araobp/can-bus/doc/requirements.pptx

Sensor/actuator CAN node

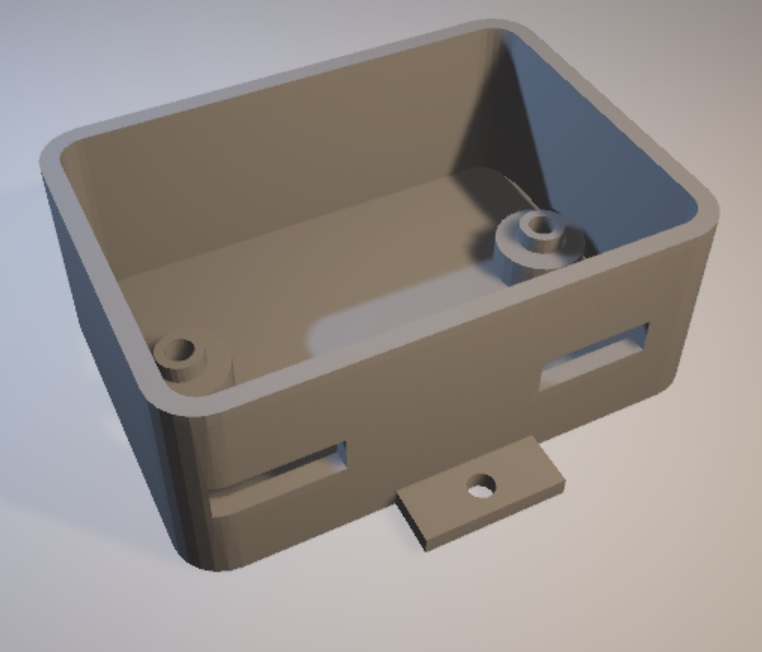
[picture p14: figure]
壁, 容器, 室内 が含まれている画像 非常に高い精度で生成された説明

Requirements for sensor/actuator node
- MCP2515 and MCP2561 on base board
- 5V three-terminal regulator (Max. 500mA)
- Polyswitch (100mA) and diode for circuit protection
- PIC16F1829 MCU on sensor/actuator board (daughter board)

CAN1

CANL

CANH

CANL

CANH

CAN0

RX

TX

GND

6V~9V

UART
