araobp/can-bus/doc/concept.pptx

Low-Power LAN

LAN and the Internet

Home controller on AWS

MQTT
client

Wireless
Sensor
(BLE etc)

Gateway
supporting CAN

Application on
RasPi or Android

CAN-MQTT Gateway
“gateway.js” on RasPi

Home controller on
RasPi or Android

Sensor
supporting CAN

Actuator
supporting CAN

CAN adapter
to UART

CAN adapter
to UART

MQTT
client

MQTT
client

MQTT-bus

- Low power consumption (a few ten mA @ 5V)
- Long range (> 50m)
- Realtime control support
- Peer-to-peer, not master-slave

CAN-bus

- Message bus over IP
- Optimized for IoT

Note: RasPi has four USB ports: can support four CAN-buses in parallel.
