araobp/can-bus/doc/universal_board.pptx

PIC16F1825 CAN node

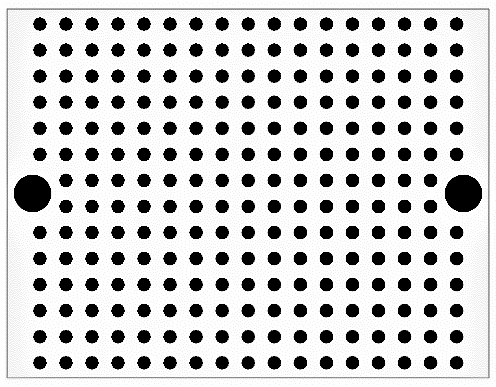
[picture p15: figure]

Murata CERALOCK 8MHz

(2)

(3)

(1)

MCP2515

VSS

OSC1

OSC2

0.1μF

RXCAN

TXCAN

SCK

SI

SO

CS

RESET

VDD

10kΩ

RA2

0.1μF

MCP2561

PIC16F1825

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
CANH

VSS

TXD

120Ω

0.1μF

51kΩ

SPLIT

CANL

STBY

JP1

VDD

Short JP1 for
120Ω termination.

UART

RX

TX

VSS

VDD

CANH

CANL

CAN

CANL

CANH

CAN
