araobp/can-bus/doc/pic16f1825-mcp2515.pptx

Tx

UART/USB(FTDI)

Rx

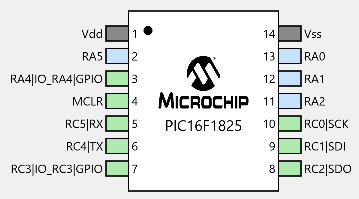
[picture p16: figure]

INT

SCK

SI

J1

CANH

SO

CANL

CS

GND

VCC

120Ω
