araobp/can-bus/doc/logic_16micro.jpg

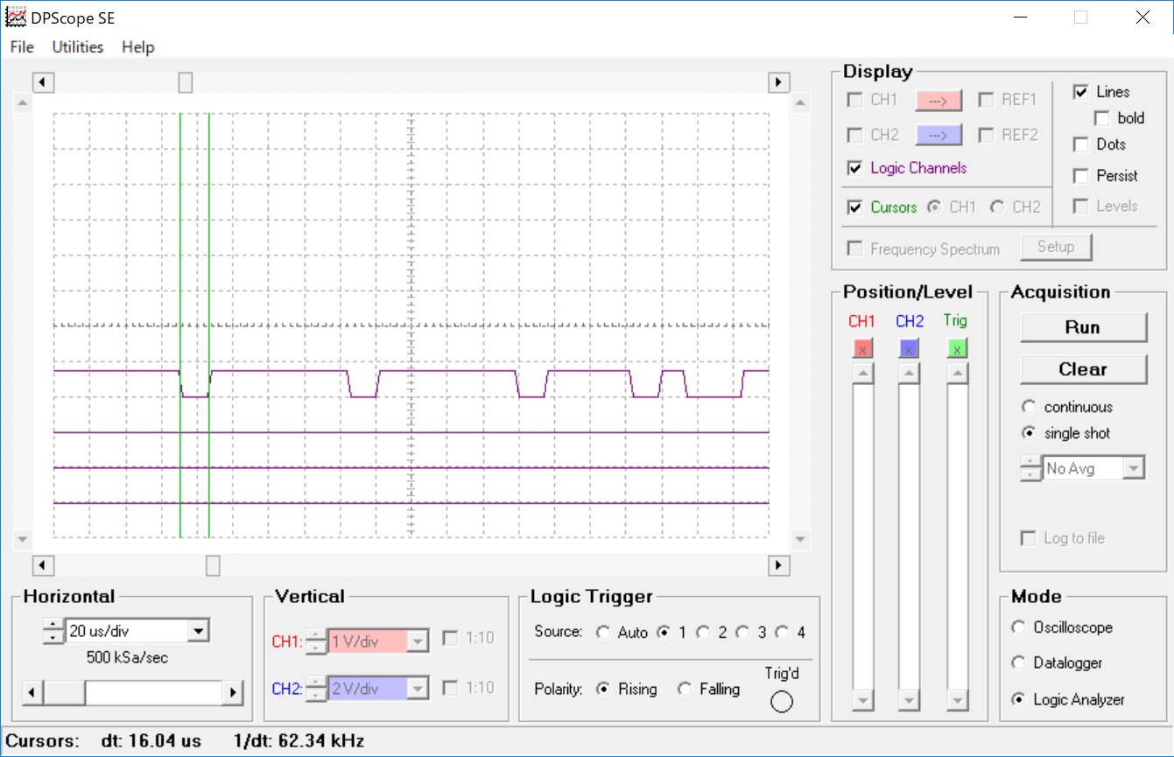
doc/logic_16micro.jpg
