araobp/can-bus/FreeCAD/adapter_to_uart_spacer.FCStd

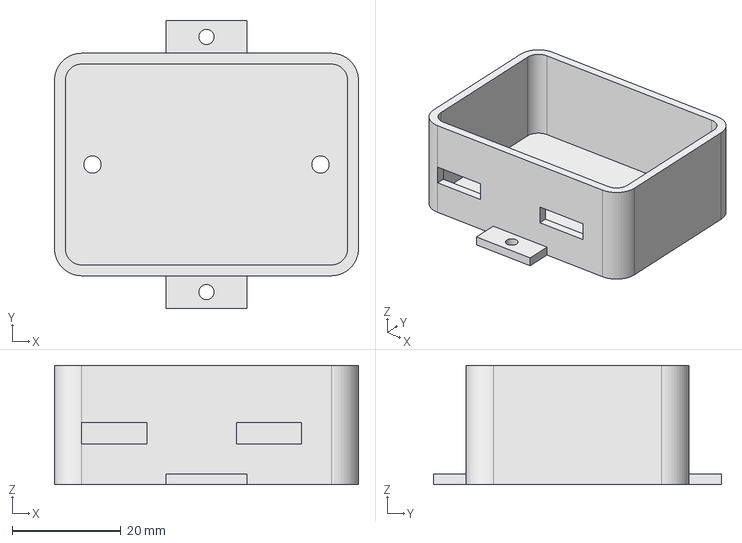
[picture p18: CAD file, 2018-04-01]
FreeCAD/adapter_to_uart_spacer.FCStd
56.0 x 53.0 x 22.0 mm
