araobp/can-bus/FreeCAD/adapter_to_uart.FCStd

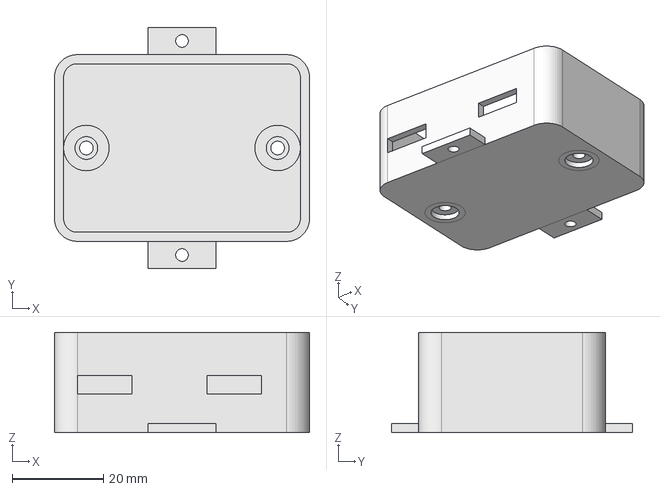
[picture p19: CAD file, 2018-04-01]
FreeCAD/adapter_to_uart.FCStd
56.0 x 53.0 x 22.0 mm
