araobp/can-bus/(list of files, cad)

Other CAD files:
pic16f1825/uart2can.X/dist/default/production/uart2can.X.production.obj
FreeCAD/adapter_to_uart_serial.stl
FreeCAD/adapter_to_uart.stl
