araobp/can-bus/doc/soldering.jpg

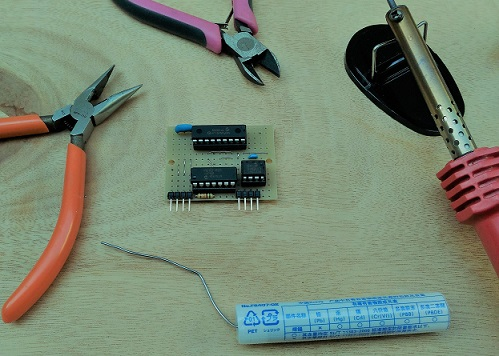
doc/soldering.jpg
