araobp/can-bus/doc/EVALUATION.md

# CAN evaluation

## Research

### Arm mbed

I evaluated ARM mbed with CAN (LPC1768/MCP2561), but ARM Cortex-M is not suitable for the goal: expensive and over spec.

The following is the waveform of CAN over the network between two LPC1768:

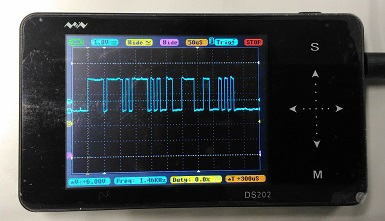
[picture p21: doc/waveform.jpg]
waveform


And the physical network:

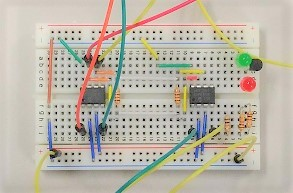
[picture p22: doc/breadboard.jpg]
breadboard


### SocketCAN and SLCAN

SocketCAN and SLCAN are interesting, so I evaluated them by re-building Raspbian to add SLCAN kernel module. But I noticed that SLCAN does not support mask/filtering on CAN controller, so I do not adopt them in this project.

## CANopen

CANopen is over-spec for this project. I will add a thin layer on top of CAN-bus instead of CANopen, because I want to use cheap and low-power 8bit MCUs such as PIC16F1 for CAN nodes.

## My original PIC16F1825 evaluation board

I use this PIC board to evaluate CAN:

pico

## Wiring with jumper cables

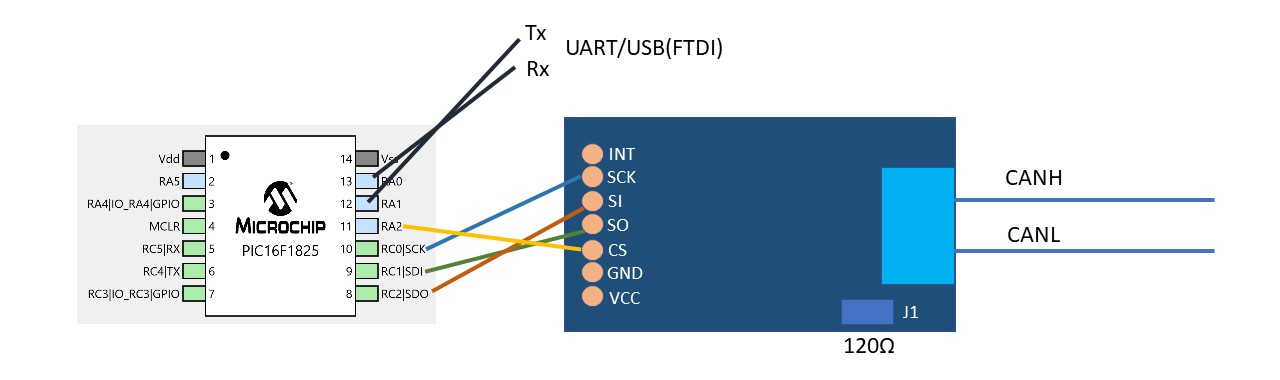
[picture p23: doc/pic16f1825-mcp2515.jpg]
connection


## 1st test on March 14th, 2018

(The problem below has already been fixed in ver 0.1 release)

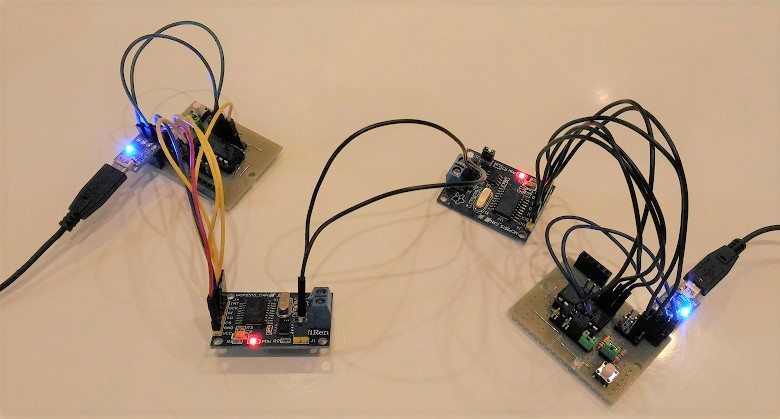
[picture p24: doc/test.jpg]
test


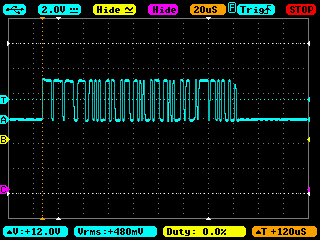
[picture p25: doc/waveform2.BMP]
waveform2


It seemed like I forgot to set CNF1, CNF2 and CNF3 to appropriate values to generate 125kbps baudrate.

Assuming that the oscillator runs at 8MHz and BRP(Buad Rate Prescaller) = 2,

```
TQ = 2*2/8MHz = 500ns  ... Equation 5-2 in P38
16TQ corresponds to 125kHz

According to 5.3 in P 41,
SyncSeg = 1 TQ,
PropSeg = 2 TQ,
PS1 = 7TQ,
PS2 = 6TQ.

Total 16TQ.

CNF1 in P42
SJW: 01
BRP: 000001

CNF2
BTLMODE: 1
SAM: 1
PHSEG1: 110
PRSEG: 001

CNF3
SOF: 0
WAKFIL: 0
PHSEG2: 101
```

So the values of CNF1, CNF2 and CNF3 would be like this:

|Register | Value  |
|---|---|
|CNF1(2Ah)|01000001|
|CNF2(29h)|11110001|
|CNF3(28h)|00000101|

## Baud rate test on March 17th, 2018

```
Voltage: CANH - CANL
1bit: 16 Time Quantum (TQ)
```
### BPR2 (16TQ = 8 micro sec, 125kHz)

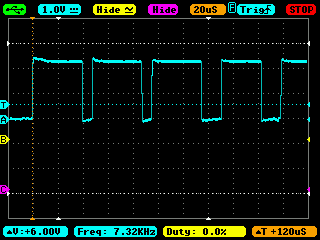
[picture p26: doc/test/BRP2.BMP]
BRP2


### BPR4 (16TQ = 16 micro sec, 62.5kHz)

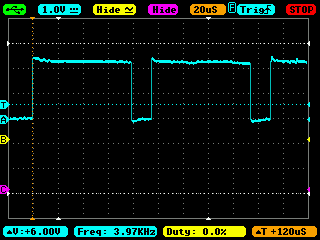
[picture p27: doc/test/BRP4.BMP]
BRP4


### BPR8 (16TQ = 32 micro sec, 31.3kHz)

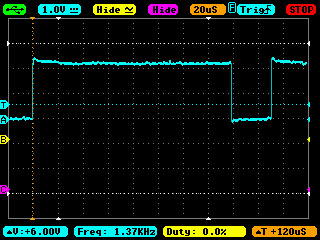
[picture p28: doc/test/BRP8.BMP]
BRP8


### BPR16 (16TQ = 64 micro sec, 15.6kHz)

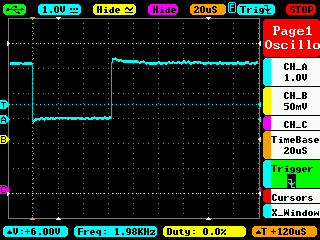
[picture p29: doc/test/BRP16.BMP]
BRP16


### Logic analyzer

I have also got this cheap oscilloscope ["PCB scope"](http://www.picaxestore.com/en_gb/osc001.html) in [my original 3D-printed case](https://github.com/araobp/3D-printing/blob/master/osc001/osc001.stl):

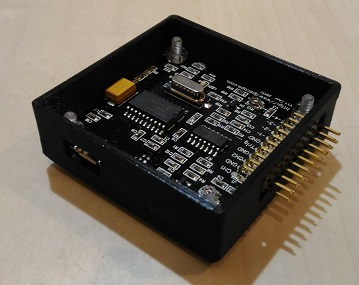
[picture p30: doc/osc001.jpg]
osc001


The following is a screen shot from the oscilloscope in logic analyzer mode:

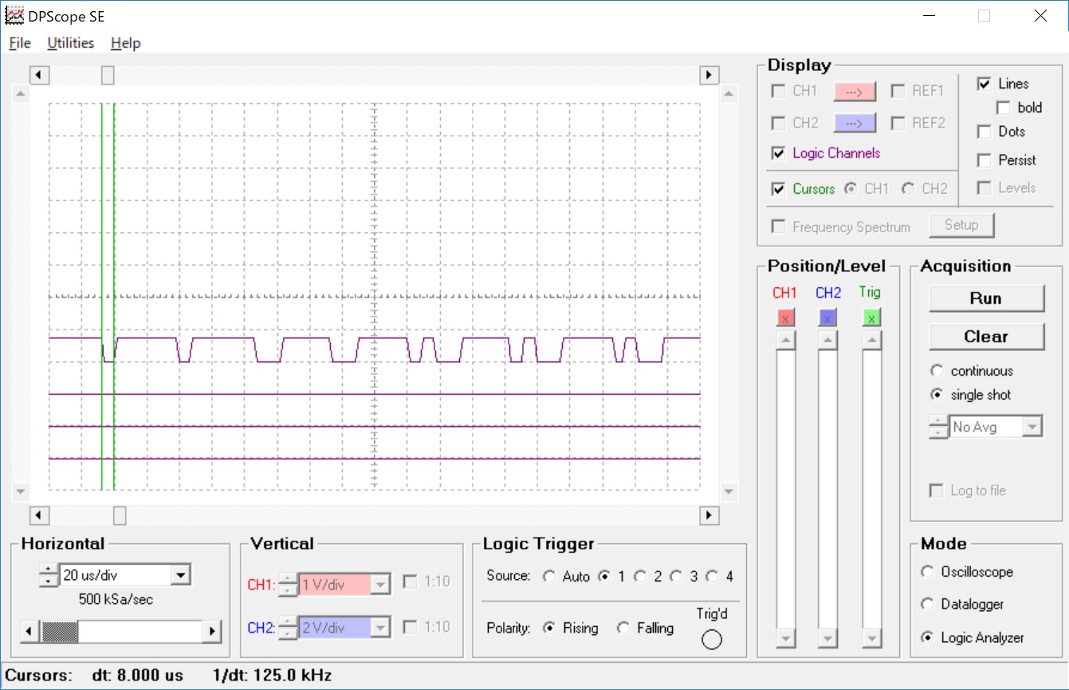
[picture p31: doc/logic_8micro.jpg]
8micro
