araobp/can-bus/KiCAD/circuit/adapter.kicad_pcb

## KiCad design KiCAD/circuit/adapter.kicad_pcb (2018-04-18)

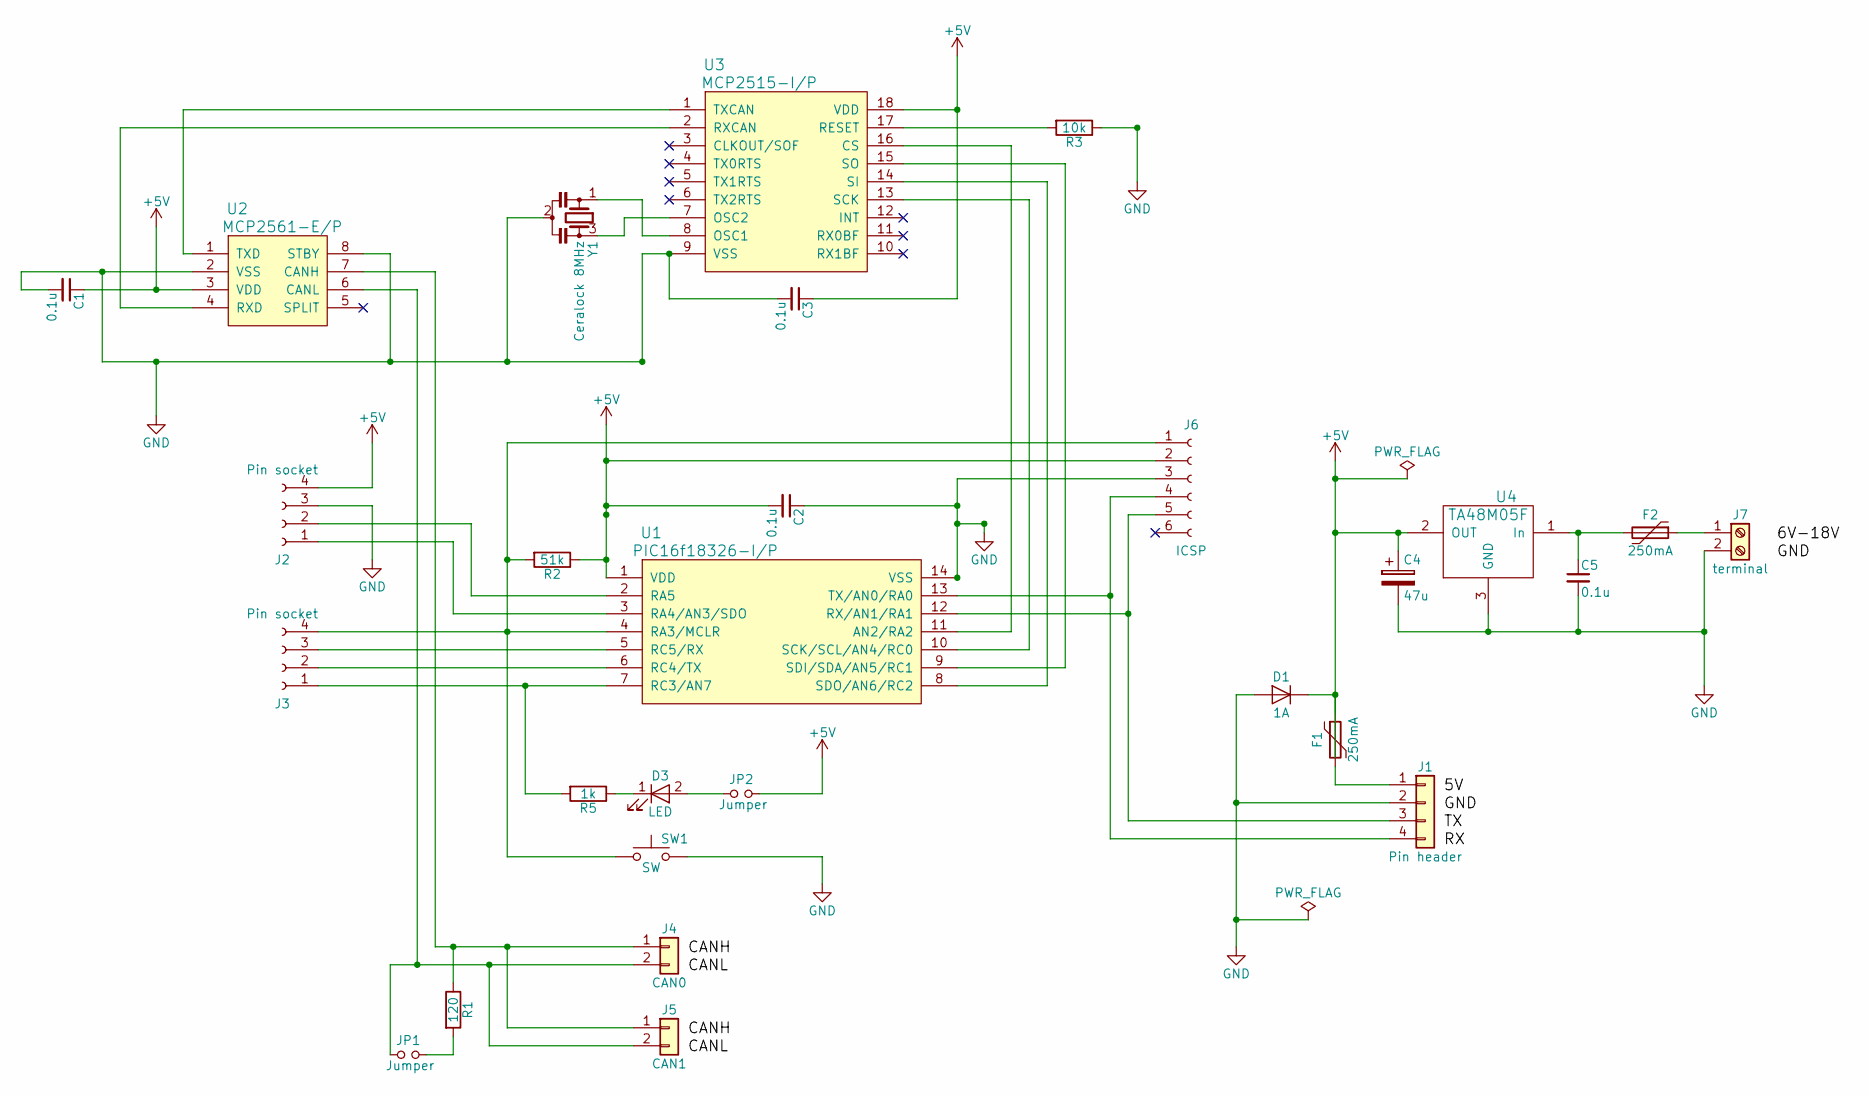
[picture p32: schematic adapter.sch, CAN node base board]

Parts:
C1, C2, C3, C5: 0.1u; Capacitor_2.54mm
C4: 47u; Capacitor_2.54mm
D1: 1A; Diode
D3: LED; Led
F1, F2: 250mA; Polyswitch_Tyco
J1: Pin header; PinHeader_1x4_L_Shape
J2, J3: Pin socket; PinSocket_1x4
J4: CAN0; PinHeader_1x2_L_Shape
J5: CAN1; PinHeader_1x2_L_Shape
J6: ICSP; PinSocket_1x6
J7: terminal; Terminal_PhoenixContact_2P
JP1, JP2: Jumper; Jumper_1x2
R1: 120; Resistor_FaithfulLink_CF25
R2: 51k; Resistor_FaithfulLink_CF25
R3: 10k; Resistor_FaithfulLink_CF25
R5: 1k; Resistor_FaithfulLink_CF25
SW1: SW; TactileSwitch
U1: PIC16f18326-I/P; IC_socket_14pins
U2: MCP2561-E/P; IC_Socket_8pins
U3: MCP2515-I/P; IC_socket_18pins
U4: TA48M05F
Y1: Ceralock 8MHz; Ceralock_Murata

Connections:
+5V: C1.1, C2.2, C3.1, C4.1, D1.1 (K), F1.1, J2.4, J6.2, JP2.2, R2.1, U1.1 (VDD), U2.3 (VDD), U3.18 (VDD), U4.2 (OUT)
GND: C1.2, C2.1, C3.2, C4.2, C5.2, D1.2 (A), J1.2, J2.3, J6.3, J7.2, R3.1, SW1.2, U1.14 (VSS), U2.2 (VSS), U2.8 (STBY), U3.9 (VSS), U4.3 (GND), Y1.2; also elsewhere on the board
unnamed: C5.1, F2.2, U4.1 (In)
unnamed: D3.1 (K), R5.1
unnamed: D3.2 (A), JP2.1
unnamed: F1.2, J1.1
unnamed: F2.1, J7.1
unnamed: J1.3, J6.5, U1.12 (RX/AN1/RA1)
unnamed: J1.4, J6.4, U1.13 (TX/AN0/RA0)
unnamed: J2.1, U1.3 (RA4/AN3/SDO)
unnamed: J2.2, U1.2 (RA5)
unnamed: J3.1, R5.2, U1.7 (RC3/AN7)
unnamed: J3.2, U1.6 (RC4/TX)
unnamed: J3.3, U1.5 (RC5/RX)
unnamed 14: J3.4, J6.1, R2.2, SW1.1, U1.4 (RA3/MCLR); also elsewhere on the board
unnamed: J4.1, J5.1, R1.1, U2.7 (CANH)
unnamed: J4.2, J5.2, JP1.1, U2.6 (CANL)
unnamed: JP1.2, R1.2
unnamed: R3.2, U3.17 (RESET)
unnamed: U1.8 (SDO/AN6/RC2), U3.14 (SI)
unnamed: U1.9 (SDI/SDA/AN5/RC1), U3.15 (SO)
unnamed: U1.10 (SCK/SCL/AN4/RC0), U3.13 (SCK)
unnamed: U1.11 (AN2/RA2), U3.16 (CS)
unnamed: U2.1 (TXD), U3.1 (TXCAN)
unnamed: U2.4 (RXD), U3.2 (RXCAN)
unnamed: U3.7 (OSC2), Y1.3
unnamed: U3.8 (OSC1), Y1.1

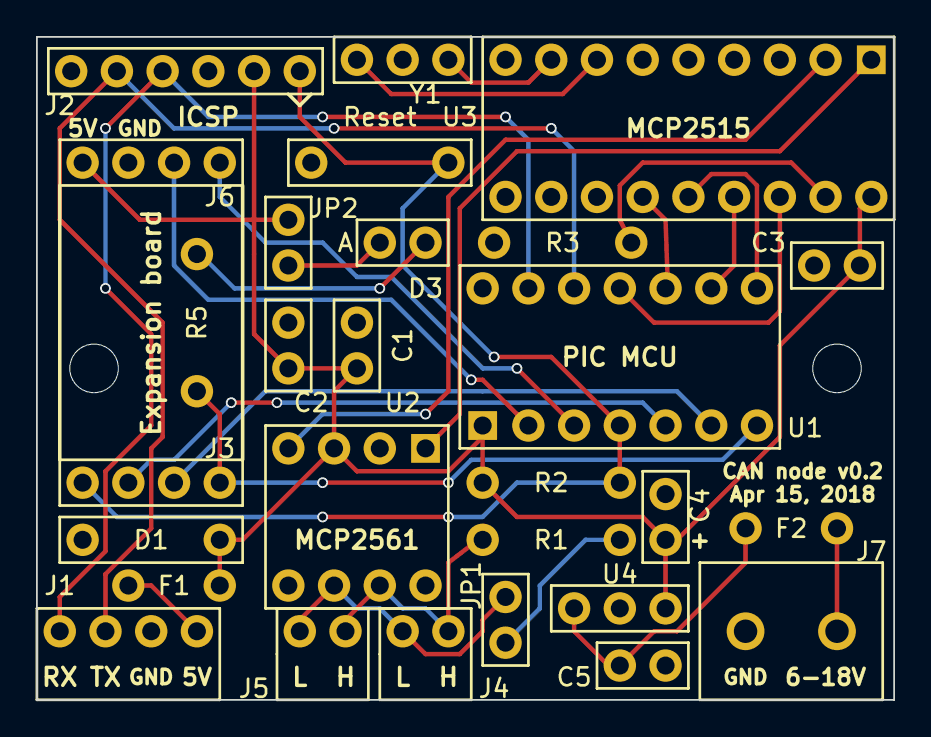
[picture p33: board adapter.kicad_pcb from above]

Board: 2 copper layers, 47.6 x 36.8 mm, 28 parts (0 on the bottom side), 27 nets.

Other parts of the board:
Reset: SW; TactileSwitch

Their connections:
GND: Reset.2; also elsewhere on the board
unnamed 14: Reset.1; also elsewhere on the board
