araobp/can-bus/pic16f1825/uart2can.X/mcc_generated_files/pin_manager.h

/**
  @Generated Pin Manager Header File

  @Company:
    Microchip Technology Inc.

  @File Name:
    pin_manager.h

  @Summary:
    This is the Pin Manager file generated using MPLAB(c) Code Configurator

  @Description:
    This header file provides implementations for pin APIs for all pins selected in the GUI.
    Generation Information :
        Product Revision  :  MPLAB(c) Code Configurator - 4.35
        Device            :  PIC16F1825
        Version           :  1.01
    The generated drivers are tested against the following:
        Compiler          :  XC8 1.35
        MPLAB             :  MPLAB X 3.40

    Copyright (c) 2013 - 2015 released Microchip Technology Inc.  All rights reserved.

    Microchip licenses to you the right to use, modify, copy and distribute
    Software only when embedded on a Microchip microcontroller or digital signal
    controller that is integrated into your product or third party product
    (pursuant to the sublicense terms in the accompanying license agreement).

    You should refer to the license agreement accompanying this Software for
    additional information regarding your rights and obligations.

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
*/


#ifndef PIN_MANAGER_H
#define PIN_MANAGER_H

#define INPUT   1
#define OUTPUT  0

#define HIGH    1
#define LOW     0

#define ANALOG      1
#define DIGITAL     0

#define PULL_UP_ENABLED      1
#define PULL_UP_DISABLED     0

// get/set RA0 procedures
#define RA0_SetHigh()    do { LATAbits.LATA0 = 1; } while(0)
#define RA0_SetLow()   do { LATAbits.LATA0 = 0; } while(0)
#define RA0_Toggle()   do { LATAbits.LATA0 = ~LATAbits.LATA0; } while(0)
#define RA0_GetValue()         PORTAbits.RA0
#define RA0_SetDigitalInput()   do { TRISAbits.TRISA0 = 1; } while(0)
#define RA0_SetDigitalOutput()  do { TRISAbits.TRISA0 = 0; } while(0)
#define RA0_SetPullup()     do { WPUAbits.WPUA0 = 1; } while(0)
#define RA0_ResetPullup()   do { WPUAbits.WPUA0 = 0; } while(0)
#define RA0_SetAnalogMode() do { ANSELAbits.ANSA0 = 1; } while(0)
#define RA0_SetDigitalMode()do { ANSELAbits.ANSA0 = 0; } while(0)

// get/set RA1 procedures
#define RA1_SetHigh()    do { LATAbits.LATA1 = 1; } while(0)
#define RA1_SetLow()   do { LATAbits.LATA1 = 0; } while(0)
#define RA1_Toggle()   do { LATAbits.LATA1 = ~LATAbits.LATA1; } while(0)
#define RA1_GetValue()         PORTAbits.RA1
#define RA1_SetDigitalInput()   do { TRISAbits.TRISA1 = 1; } while(0)
#define RA1_SetDigitalOutput()  do { TRISAbits.TRISA1 = 0; } while(0)
#define RA1_SetPullup()     do { WPUAbits.WPUA1 = 1; } while(0)
#define RA1_ResetPullup()   do { WPUAbits.WPUA1 = 0; } while(0)
#define RA1_SetAnalogMode() do { ANSELAbits.ANSA1 = 1; } while(0)
#define RA1_SetDigitalMode()do { ANSELAbits.ANSA1 = 0; } while(0)

// get/set IO_RA2 aliases
#define IO_RA2_TRIS               TRISAbits.TRISA2
#define IO_RA2_LAT                LATAbits.LATA2
#define IO_RA2_PORT               PORTAbits.RA2
#define IO_RA2_WPU                WPUAbits.WPUA2
#define IO_RA2_ANS                ANSELAbits.ANSA2
#define IO_RA2_SetHigh()            do { LATAbits.LATA2 = 1; } while(0)
#define IO_RA2_SetLow()             do { LATAbits.LATA2 = 0; } while(0)
#define IO_RA2_Toggle()             do { LATAbits.LATA2 = ~LATAbits.LATA2; } while(0)
#define IO_RA2_GetValue()           PORTAbits.RA2
#define IO_RA2_SetDigitalInput()    do { TRISAbits.TRISA2 = 1; } while(0)
#define IO_RA2_SetDigitalOutput()   do { TRISAbits.TRISA2 = 0; } while(0)
#define IO_RA2_SetPullup()      do { WPUAbits.WPUA2 = 1; } while(0)
#define IO_RA2_ResetPullup()    do { WPUAbits.WPUA2 = 0; } while(0)
#define IO_RA2_SetAnalogMode()  do { ANSELAbits.ANSA2 = 1; } while(0)
#define IO_RA2_SetDigitalMode() do { ANSELAbits.ANSA2 = 0; } while(0)

// get/set SCK aliases
#define SCK_TRIS               TRISCbits.TRISC0
#define SCK_LAT                LATCbits.LATC0
#define SCK_PORT               PORTCbits.RC0
#define SCK_WPU                WPUCbits.WPUC0
#define SCK_ANS                ANSELCbits.ANSC0
#define SCK_SetHigh()            do { LATCbits.LATC0 = 1; } while(0)
#define SCK_SetLow()             do { LATCbits.LATC0 = 0; } while(0)
#define SCK_Toggle()             do { LATCbits.LATC0 = ~LATCbits.LATC0; } while(0)
#define SCK_GetValue()           PORTCbits.RC0
#define SCK_SetDigitalInput()    do { TRISCbits.TRISC0 = 1; } while(0)
#define SCK_SetDigitalOutput()   do { TRISCbits.TRISC0 = 0; } while(0)
#define SCK_SetPullup()      do { WPUCbits.WPUC0 = 1; } while(0)
#define SCK_ResetPullup()    do { WPUCbits.WPUC0 = 0; } while(0)
#define SCK_SetAnalogMode()  do { ANSELCbits.ANSC0 = 1; } while(0)
#define SCK_SetDigitalMode() do { ANSELCbits.ANSC0 = 0; } while(0)

// get/set SDI aliases
#define SDI_TRIS               TRISCbits.TRISC1
#define SDI_LAT                LATCbits.LATC1
#define SDI_PORT               PORTCbits.RC1
#define SDI_WPU                WPUCbits.WPUC1
#define SDI_ANS                ANSELCbits.ANSC1
#define SDI_SetHigh()            do { LATCbits.LATC1 = 1; } while(0)
#define SDI_SetLow()             do { LATCbits.LATC1 = 0; } while(0)
#define SDI_Toggle()             do { LATCbits.LATC1 = ~LATCbits.LATC1; } while(0)
#define SDI_GetValue()           PORTCbits.RC1
#define SDI_SetDigitalInput()    do { TRISCbits.TRISC1 = 1; } while(0)
#define SDI_SetDigitalOutput()   do { TRISCbits.TRISC1 = 0; } while(0)
#define SDI_SetPullup()      do { WPUCbits.WPUC1 = 1; } while(0)
#define SDI_ResetPullup()    do { WPUCbits.WPUC1 = 0; } while(0)
#define SDI_SetAnalogMode()  do { ANSELCbits.ANSC1 = 1; } while(0)
#define SDI_SetDigitalMode() do { ANSELCbits.ANSC1 = 0; } while(0)

// get/set SDO aliases
#define SDO_TRIS               TRISCbits.TRISC2
#define SDO_LAT                LATCbits.LATC2
#define SDO_PORT               PORTCbits.RC2
#define SDO_WPU                WPUCbits.WPUC2
#define SDO_ANS                ANSELCbits.ANSC2
#define SDO_SetHigh()            do { LATCbits.LATC2 = 1; } while(0)
#define SDO_SetLow()             do { LATCbits.LATC2 = 0; } while(0)
#define SDO_Toggle()             do { LATCbits.LATC2 = ~LATCbits.LATC2; } while(0)
#define SDO_GetValue()           PORTCbits.RC2
#define SDO_SetDigitalInput()    do { TRISCbits.TRISC2 = 1; } while(0)
#define SDO_SetDigitalOutput()   do { TRISCbits.TRISC2 = 0; } while(0)
#define SDO_SetPullup()      do { WPUCbits.WPUC2 = 1; } while(0)
#define SDO_ResetPullup()    do { WPUCbits.WPUC2 = 0; } while(0)
#define SDO_SetAnalogMode()  do { ANSELCbits.ANSC2 = 1; } while(0)
#define SDO_SetDigitalMode() do { ANSELCbits.ANSC2 = 0; } while(0)

// get/set IO_RC3 aliases
#define IO_RC3_TRIS               TRISCbits.TRISC3
#define IO_RC3_LAT                LATCbits.LATC3
#define IO_RC3_PORT               PORTCbits.RC3
#define IO_RC3_WPU                WPUCbits.WPUC3
#define IO_RC3_ANS                ANSELCbits.ANSC3
#define IO_RC3_SetHigh()            do { LATCbits.LATC3 = 1; } while(0)
#define IO_RC3_SetLow()             do { LATCbits.LATC3 = 0; } while(0)
#define IO_RC3_Toggle()             do { LATCbits.LATC3 = ~LATCbits.LATC3; } while(0)
#define IO_RC3_GetValue()           PORTCbits.RC3
#define IO_RC3_SetDigitalInput()    do { TRISCbits.TRISC3 = 1; } while(0)
#define IO_RC3_SetDigitalOutput()   do { TRISCbits.TRISC3 = 0; } while(0)
#define IO_RC3_SetPullup()      do { WPUCbits.WPUC3 = 1; } while(0)
#define IO_RC3_ResetPullup()    do { WPUCbits.WPUC3 = 0; } while(0)
#define IO_RC3_SetAnalogMode()  do { ANSELCbits.ANSC3 = 1; } while(0)
#define IO_RC3_SetDigitalMode() do { ANSELCbits.ANSC3 = 0; } while(0)

/**
   @Param
    none
   @Returns
    none
   @Description
    GPIO and peripheral I/O initialization
   @Example
    PIN_MANAGER_Initialize();
 */
void PIN_MANAGER_Initialize (void);

/**
 * @Param
    none
 * @Returns
    none
 * @Description
    Interrupt on Change Handling routine
 * @Example
    PIN_MANAGER_IOC();
 */
void PIN_MANAGER_IOC(void);



#endif // PIN_MANAGER_H
/**
 End of File
*/
