araobp/can-bus/(commit log)

2018-03-11 update
    Add SPI write routine
    [uart2can.X.production.obj]
2018-03-13 basic functionality completed
    [uart2can.X.production.obj]
2018-03-13 command update
    [uart2can.X.production.obj]
2018-03-14 CNF1 to CNF3 config
    [uart2can.X.production.obj]
2018-03-16 Version 0.1 (March 18, 2018)
    Version 0.1 release
    [uart2can.X.production.obj]
2018-03-17 bug fix
    CNF1 not initialized correctly
    [uart2can.X.production.obj]
2018-03-17 universal board
2018-03-22 SLCAN support (partly)
    [uart2can.X.production.obj]
2018-03-22 SLCAN support
    [uart2can.X.production.obj]
2018-03-23 Remove SLCAN support
    [uart2can.X.production.obj]
2018-03-24 circuit update
    [uart2can.X.production.obj]
2018-03-26 clock speed 32MHz
    2MHz is too slow to receive data from UART.
    [uart2can.X.production.obj]
2018-03-26 bug fix
    [uart2can.X.production.obj]
2018-03-27 daisy chain
2018-03-31 3D cad data
    [adapter_to_uart.FCStd, adapter_to_uart.stl]
2018-03-31 3D CAD data update
    [adapter_to_uart.FCStd, adapter_to_uart.stl]
2018-04-01 cad data update
    [adapter_to_uart.FCStd, adapter_to_uart.stl, adapter_to_uart_serial.stl, adapter_to_uart_spacer.FCStd]
2018-04-03 KiCAD folder
    [adapter.kicad_pcb, adapter.sch]
2018-04-03 cad to FreeCAD
    [adapter_to_uart.FCStd, adapter_to_uart.stl, adapter_to_uart_serial.stl, adapter_to_uart_spacer.FCStd]
2018-04-04 KiCAD data update
    [adapter.sch]
2018-04-18 add thermistor project
    [adapter.kicad_pcb, thermistor.kicad_pcb, thermistor.sch]
